LukePepin/Marco-Polo/successhider.md

hider@ISE-hider:~/Documents/Marco-Polo $ python hider_node.py
========================================
        HIDER NODE (UWB TX)             
========================================
✅ Connected to Arduino on /dev/ttyACM0

>>> Instructions: Press ENTER to trigger a wireless PING broadcast.
>>> Press Ctrl+C to exit.

>>> Sending 'SEND_PING' Command to Arduino...

[Arduino]: PING_SENT_SUCCESSFULLY

>>> Sending 'SEND_PING' Command to Arduino...

[Arduino]: PING_SENT_SUCCESSFULLY

>>> Sending 'SEND_PING' Command to Arduino...

[Arduino]: PING_SENT_SUCCESSFULLY
