LukePepin/Marco-Polo/successseeker.md

seeker@ISE-seeker:~/Documents/Marco-Polo $ python seeker_node.py
========================================
        SEEKER NODE (UWB RX)            
========================================
✅ Connected to Arduino on /dev/ttyACM1
>>> Listening the airwaves for UWB Pings from the Hider...
>>> Press Ctrl+C to exit.

🚀 >>> SUCCESS: UWB PING DETECTED WIRELESSLY FROM HIDER! <<< 🚀

🚀 >>> SUCCESS: UWB PING DETECTED WIRELESSLY FROM HIDER! <<< 🚀

🚀 >>> SUCCESS: UWB PING DETECTED WIRELESSLY FROM HIDER! <<< 🚀
