LukePepin/Marco-Polo/docs/Gantt_Matt_Inputs.docx

Gantt

W1 | W2 | W3 | W4 | W5 | W6 | W7 | W8 | W9 | W10
May 18-24 | May 25-31 | Jun 1-7 | Jun 8-14 | Jun 15-21 | Jun 22-28 | Jun 29-Jul 5 | Jul 6-12 | Jul 13-19 | Jul 20-26

Completed Work and Near-Term Transition

Task | W1 | W2 | W3 | W4 | W5 | W6 | W7 | W8 | W9 | W10 | Notes
Project charter | | | | | | | | | | | Project scope, deliverables, initial plan.
Team charter | | | | | | | | | | | Roles, expectations, communication.
Customer requirements / engineering specs | | | | | | | | | | | Portable, low-cost, offline-capable tracking system.
Initial architecture / block diagram | | | | | | | | | | | Hider, Seeker, LoRa, BLE, GPS, NUC, MQTT, Node-RED.
Hardware platform and integrations | | | | | | | | | | | T-Beams, NUC/laptop, MQTT, logging, maps.
LoRa GPS design | | | | | | | | | | | Packet design and LoRa/GPS architecture.
Build Hider/Seeker LoRa communication | | | | | | | | | | | Basic LoRa TX/RX working.
GPS-over-LoRa implementation | | | | | | | | | | | Hider GPS transmitted and Seeker parsed it.
LoRa RSSI long-range foxhunting | | | | | | | | | | | No-GPS long-range hot/cold tracking.
BLE close-range foxhunting | | | | | | | | | | | Close-range tracking and LoRa-to-BLE handoff.
Hider motion detection and case | | | | | | | | | | | Motion detection started; 3D case completed.
Node-RED/MQTT mapping integration | | | | | | | | | | | Laptop and NUC mapping pipeline established.
JSON telemetry and logging | | | | | | | | | | | Seeker outputs JSON; CSV/SQL logging explored.
NUC hotspot and wireless mapping | | | | | | | | | | | Battery NUC hotspot and wireless Seeker telemetry working.
Initial offline map investigation | | | | | | | | | | | Offline mapping research and first attempts.
Distance and bearing refinement | | | | | | | | | | | Polish GPS-to-GPS distance and bearing.
Map display improvements | | | | | | | | | | | Labels, map line, clearer Hider/Seeker visualization.
GPS / LoRa RSSI / BLE RSSI filtering | | | | | | | | | | | Moving average/median/weighted smoothing.
Navigation guidance | | | | | | | | | | | Closer/farther, bearing, direction prompts.
LoRa-to-BLE handoff tuning and tests | | | | | | | | | | | Field test long-range LoRa and close-range BLE.
Motion alerting fix | | | | | | | | | | | Alert thresholds, false alert reduction, telemetry output.
Hider battery / sleep optimization | | | | | | | | | | | Wake-on-move, periodic chirps, longer sleep life.
Offline mapping integration | | | | | | | | | | | Offline/cached local map for NUC field system.
End-to-end field testing | | | | | | | | | | | Hider-Seeker-NUC-map test with logging.
Direction-finding attempt | | | | | | | | | | | RSSI/antenna direction finding evaluation.
Directional RSSI data collection | | | | | | | | | | | Collect and analyze LoRa/BLE directional signal data.
Test data analysis vs requirements | | | | | | | | | | | Compare performance to requirements and limitations.
Final system refinement | | | | | | | | | | | Stabilize firmware, mapping, navigation, and demo flow.
Final demo / report / presentation | | | | | | | | | | | Final test results, cost, lessons learned, future work.
