LukePepin/Marco-Polo/UWB/UWB.docx

# Tab 1

In order to wire the UWB1000 to the Arduino 33 BLE Sense Lite, connect the following using dupont wires:

IRQ - D2

GND - GND

CLK - D13

MISO - D12

MOSI - D11

CSN - D10

WAKE - D4

RSTN - D3

VCC - 3.3V

GND - GND

Receiver: #include <SPI.h>

#include <DW1000.h>

const uint8_t PIN_CS = 10;

const uint8_t PIN_IRQ = 2;

const uint8_t PIN_RST = 3;

volatile boolean received = false;

volatile int interruptCount = 0;

byte data[128];

void setup() {

Serial.begin(115200);

while (!Serial) { delay(10); }

Serial.println("DWM1000 UWB Receiver - Diagnostic Mode");

// Configure interrupt pin as input

pinMode(PIN_IRQ, INPUT);

SPI.begin();

SPI.beginTransaction(SPISettings(16000000, MSBFIRST, SPI_MODE0));

DW1000.begin(PIN_IRQ, PIN_RST);

DW1000.select(PIN_CS);

Serial.println("Configuring...");

DW1000.newConfiguration();

DW1000.setDefaults();

DW1000.setDeviceAddress(2);

DW1000.setNetworkId(10);

DW1000.enableMode(DW1000.MODE_LONGDATA_RANGE_LOWPOWER);

DW1000.commitConfiguration();

// Print device info

char msg_info[128];

DW1000.getPrintableDeviceIdentifier(msg_info);

Serial.print("Device ID: "); Serial.println(msg_info);

DW1000.getPrintableExtendedUniqueIdentifier(msg_info);

Serial.print("Unique ID: "); Serial.println(msg_info);

DW1000.getPrintableNetworkIdAndShortAddress(msg_info);

Serial.print("Network ID & Address: "); Serial.println(msg_info);

// Attach interrupt BEFORE starting receive

attachInterrupt(digitalPinToInterrupt(PIN_IRQ), handleReceived, RISING);

DW1000.attachReceivedHandler(handleReceived);

// Start receiver

DW1000.newReceive();

DW1000.setDefaults();

DW1000.receivePermanently(true);

DW1000.startReceive();

Serial.println("Receiver ready - waiting for packets...");

Serial.println("Monitoring IRQ pin state:");

}

unsigned long lastCheck = 0;

unsigned long lastInterrupt = 0;

void loop() {

// Check interrupt flag

if (received) {

received = false;

lastInterrupt = millis();

Serial.println("\n>>> Packet received! <<<");

// Get data length

uint16_t len = DW1000.getDataLength();

Serial.print("Data length: "); Serial.println(len);

if (len > 0 && len < 128) {

DW1000.getData(data, len);

Serial.print("Received: ");

Serial.println((char*)data);

// Get signal quality

float rxPower = DW1000.getReceivePower();

float fpPower = DW1000.getFirstPathPower();

Serial.print("RX Power: "); Serial.print(rxPower); Serial.println(" dBm");

Serial.print("FP Power: "); Serial.print(fpPower); Serial.println(" dBm");

}

Serial.print("Total interrupts: "); Serial.println(interruptCount);

Serial.println();

}

// Periodic status check

if (millis() - lastCheck > 5000) {

lastCheck = millis();

Serial.print("[Status] IRQ count: "); Serial.print(interruptCount);

Serial.print(" | IRQ pin: "); Serial.print(digitalRead(PIN_IRQ));

Serial.print(" | Last RX: ");

if (lastInterrupt > 0) {

Serial.print((millis() - lastInterrupt) / 1000);

Serial.println(" sec ago");

} else {

Serial.println("never");

}

// Check if we're still in receive mode (fixed - no DW1000. prefix)

byte sysctrl[4];

DW1000.readBytes(SYS_CTRL, NO_SUB, sysctrl, 4);

Serial.print("SYS_CTRL: 0x");

for (int i = 3; i >= 0; i--) {

if (sysctrl[i] < 0x10) Serial.print("0");

Serial.print(sysctrl[i], HEX);

}

Serial.println();

}

}

void handleReceived() {

received = true;

interruptCount++;

}

Transmitter:

#include <SPI.h>

#include <DW1000.h>

// Pin definitions for your setup

const uint8_t PIN_CS = 10; // DW_NSS

const uint8_t PIN_IRQ = 2; // DW_IRQn

const uint8_t PIN_RST = 3; // DW_RSTn

// Message to transmit

char msg[] = "Hello UWB!";

byte data[128];

int data_len;

// Transmit interval

unsigned long lastTxTime = 0;

const unsigned long TX_INTERVAL = 1000; // 1 second

void setup() {

Serial.begin(115200);

while (!Serial) { delay(10); }

Serial.println("DWM1000 UWB Transmitter");

Serial.println("Initializing...");

// Initialize SPI

SPI.begin();

SPI.beginTransaction(SPISettings(16000000, MSBFIRST, SPI_MODE0));

// Initialize DW1000

DW1000.begin(PIN_IRQ, PIN_RST);

DW1000.select(PIN_CS);

Serial.println("DW1000 initialized");

// Configure device

DW1000.newConfiguration();

DW1000.setDefaults();

DW1000.setDeviceAddress(1);

DW1000.setNetworkId(10);

DW1000.enableMode(DW1000.MODE_LONGDATA_RANGE_LOWPOWER);

DW1000.commitConfiguration();

Serial.println("Configuration committed");

// Print device info

char msg_info[128];

DW1000.getPrintableDeviceIdentifier(msg_info);

Serial.print("Device ID: ");

Serial.println(msg_info);

DW1000.getPrintableExtendedUniqueIdentifier(msg_info);

Serial.print("Unique ID: ");

Serial.println(msg_info);

DW1000.getPrintableNetworkIdAndShortAddress(msg_info);

Serial.print("Network ID & Address: ");

Serial.println(msg_info);

Serial.println("Ready to transmit");

}

void loop() {

unsigned long currentTime = millis();

// Transmit at regular intervals

if (currentTime - lastTxTime >= TX_INTERVAL) {

transmitMessage();

lastTxTime = currentTime;

}

}

void transmitMessage() {

// Prepare data

data_len = strlen(msg) + 1;

memcpy(data, msg, data_len);

// Transmit

DW1000.newTransmit();

DW1000.setDefaults();

DW1000.setData(data, data_len);

DW1000.startTransmit();

Serial.print("Transmitted: ");

Serial.println(msg);

// Wait for transmission to complete (optional but good practice)

delay(10);

}

Tag Debug

Device ID: DECA - model: 1, version: 3, revision: 0

Address: PAN: 0A, Short Address: 02

Tag ready

Sending POLL

Sending POLL

Sending POLL

Sending POLL

Sending POLL

Sending POLL

Sending POLL

Sending POLL

Anchor Debug

Device ID: DECA - model: 1, version: 3, revision: 0

Address: PAN: 0A, Short Address: 01

Anchor ready - expecting POLL

Loop alive | received=0 sentAck=0

Loop alive | received=0 sentAck=0

Loop alive | received=0 sentAck=0

Loop alive | received=0 sentAck=0

Loop alive | received=0 sentAck=0

Loop alive | received=0 sentAck=0

Tag’s Output:

device address: 7D:00:22:EA:82:60:3B:9C

### TAG ###

Anchor’s output:

device address: 82:17:5B:D5:A9:9A:E2:9C

### ANCHOR ###

### DW1000-arduino-ranging-tag ###

DW1000 initialized ...

Committed configuration ...

Device ID: DECA - model: 1, version: 3, revision: 0

Unique ID: FF:FF:FF:FF:00:00:00:00

Network ID & Device Address: PAN: 0A, Short Address: 02

Device mode: Data rate: 110 kb/s, PRF: 16 MHz, Preamble: 2048 symbols (code #4), Channel: #5

The Arduino Stella UWB and Portenta UWB Shield use a different protocol than the DWM1000 modules. The DWM1000 uses an older, simpler method of communication and cannot communicate with the Stella over UWB.

The DWM1000 is an IEEE 802.15.4a / 802.15.4-2011 HRP UWB transceiver

Arduino Stella uses Truesense DCU040, based on NXP Trimension SR040, with an integrated FiRa MAC

### DW1000-arduino-ranging-anchor (Nano 33 BLE Sense Lite) ###

DW1000 initialized ...

Committed configuration ...

Device ID: DECA - model: 1, version: 3, revision: 0

Unique ID: FF:FF:FF:FF:00:00:00:00

Network ID & Device Address: PAN: 0A, Short Address: 01

Device mode: Data rate: 110 kb/s, PRF: 16 MHz, Preamble: 2048 symbols (code #4), Channel: #5

Anchor ready, waiting for POLL...

[DBG] irqCount=1 sentAck=0 receivedAck=0 irqLevel=0

[DBG] irqCount=3136 sentAck=0 receivedAck=0 irqLevel=0

[DBG] irqCount=6267 sentAck=0 receivedAck=0 irqLevel=0

[DBG] irqCount=9399 sentAck=0 receivedAck=0 irqLevel=0

[DBG] irqCount=12531 sentAck=0 receivedAck=0 irqLevel=0

[DBG] irqCount=15665 sentAck=0 receivedAck=0 irqLevel=0

[DBG] irqCount=18800 sentAck=0 receivedAck=0 irqLevel=0

[DBG] irqCount=21937 sentAck=0 receivedAck=0 irqLevel=0

And here is the output from the Tag, notably it prints out the last irqLevel=1 which is new.

### DW1000-arduino-ranging-tag (Nano 33 BLE Sense Lite) ###

DW1000 initialized ...

Committed configuration ...

Device ID: DECA - model: 1, version: 3, revision: 0

Unique ID: FF:FF:FF:FF:00:00:00:00

Network ID & Device Address: PAN: 0A, Short Address: 02

Device mode: Data rate: 110 kb/s, PRF: 16 MHz, Preamble: 2048 symbols (code #4), Channel: #5

Tag started, sending POLL...

[DBG] irqCount=1 sentAck=0 receivedAck=0 irqLevel=0

[DBG] irqCount=8 sentAck=0 receivedAck=0 irqLevel=1

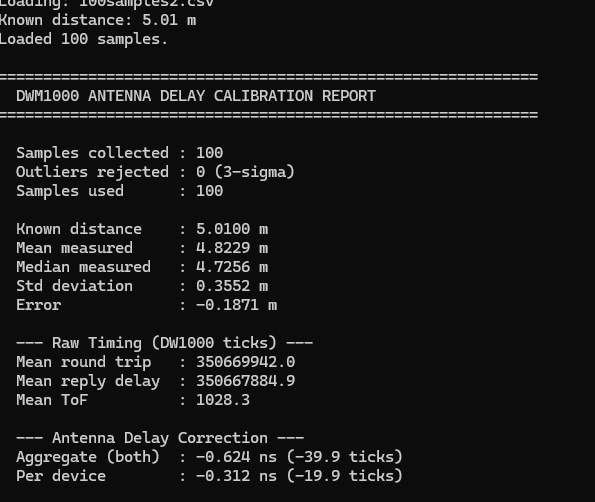
[picture p1: figure]

# Tab 2

Transmitter Code:
#include <SPI.h>

#include <DW1000.h>

const uint8_t PIN_CS = 10;

const uint8_t PIN_IRQ = 2;

const uint8_t PIN_RST = 3;

int txCount = 0;

void setup() {

Serial.begin(115200);

while (!Serial) { delay(10); }

Serial.println("=== TRANSMITTER (Auto-Sleep Disabled) ===\n");

DW1000.begin(PIN_IRQ, PIN_RST);

DW1000.select(PIN_CS);

DW1000.newConfiguration();

DW1000.setDefaults();

DW1000.setDeviceAddress(1);

DW1000.setNetworkId(10);

DW1000.enableMode(DW1000.MODE_LONGDATA_RANGE_LOWPOWER);

DW1000.commitConfiguration();

// CRITICAL: Disable auto-sleep after TX

// PMSC_CTRL1 is at register 0x36, sub-address 0x04

// ATXSLP is bit 11, ARXSLP is bit 12

// Read current value, clear those bits, write back

byte pmsc[4];

DW1000.readBytes(0x36, 0x04, pmsc, 4);

Serial.print("PMSC_CTRL1 before: 0x");

for (int i = 3; i >= 0; i--) {

if (pmsc[i] < 0x10) Serial.print("0");

Serial.print(pmsc[i], HEX);

}

Serial.println();

// Clear ATXSLP (bit 11) and ARXSLP (bit 12)

pmsc[1] &= ~0x18; // Clear bits 11 and 12 (0x08 and 0x10 in byte 1)

DW1000.writeBytes(0x36, 0x04, pmsc, 4);

// Verify

DW1000.readBytes(0x36, 0x04, pmsc, 4);

Serial.print("PMSC_CTRL1 after: 0x");

for (int i = 3; i >= 0; i--) {

if (pmsc[i] < 0x10) Serial.print("0");

Serial.print(pmsc[i], HEX);

}

Serial.println();

// Also disable interrupt mask to prevent any IRQ issues

byte zeros[4] = {0x00, 0x00, 0x00, 0x00};

DW1000.writeBytes(SYS_MASK, NO_SUB, zeros, 4);

char msg[128];

DW1000.getPrintableDeviceIdentifier(msg);

Serial.print("Device: "); Serial.println(msg);

Serial.println("\nTransmitting every 1 second...\n");

}

void loop() {

txCount++;

char msg[32];

sprintf(msg, "PING %d", txCount);

DW1000.newTransmit();

DW1000.setDefaults();

DW1000.setData((byte*)msg, strlen(msg) + 1);

DW1000.startTransmit();

// Poll for TX complete

byte status[5];

unsigned long start = millis();

while ((millis() - start) < 100) {

DW1000.readBytes(SYS_STATUS, NO_SUB, status, 5);

if (status[0] & 0x80) break; // TXFRS - frame sent

delayMicroseconds(100);

}

Serial.print("TX #"); Serial.print(txCount);

Serial.print(": "); Serial.println(msg);

// Clear status bits

byte clear[5] = {0xFF, 0xFF, 0xFF, 0xFF, 0xFF};

DW1000.writeBytes(SYS_STATUS, NO_SUB, clear, 5);

delay(1000);

}

Receiver Code:
#include <SPI.h>

#include <DW1000.h>

const uint8_t PIN_CS = 10;

const uint8_t PIN_IRQ = 2;

const uint8_t PIN_RST = 3;

byte data[128];

int rxCount = 0;

void setup() {

Serial.begin(115200);

while (!Serial) { delay(10); }

Serial.println("=== ENHANCED RECEIVER ===\n");

DW1000.begin(PIN_IRQ, PIN_RST);

DW1000.select(PIN_CS);

DW1000.newConfiguration();

DW1000.setDefaults();

DW1000.setDeviceAddress(2);

DW1000.setNetworkId(10);

DW1000.enableMode(DW1000.MODE_LONGDATA_RANGE_LOWPOWER);

DW1000.commitConfiguration();

char msg[128];

DW1000.getPrintableDeviceIdentifier(msg);

Serial.print("Device: "); Serial.println(msg);

startReceiver();

Serial.println("Listening...\n");

}

void loop() {

byte status[5];

DW1000.readBytes(SYS_STATUS, NO_SUB, status, 5);

boolean dataReady = (status[1] & 0x20);

boolean goodCRC = (status[1] & 0x40);

if (dataReady) {

rxCount++;

if (goodCRC) {

uint16_t len = DW1000.getDataLength();

if (len > 0 && len < 128) {

DW1000.getData(data, len);

data[len] = 0;

// Get RX timestamp (40-bit, ~15.65 ps resolution)

DW1000Time rxTime;

DW1000.getReceiveTimestamp(rxTime);

// Get signal quality metrics

float rxPower = DW1000.getReceivePower(); // Total RX power (dBm)

float fpPower = DW1000.getFirstPathPower(); // First path power (dBm)

float quality = DW1000.getReceiveQuality(); // Signal quality indicator

// Read frame info register for more details

byte finfo[4];

DW1000.readBytes(RX_FINFO, NO_SUB, finfo, 4);

uint16_t frameLen = (finfo[0] | ((finfo[1] & 0x03) << 8));

uint8_t rxPACC = ((finfo[2] >> 4) | ((finfo[3] & 0x0F) << 4)); // Preamble symbols accumulated

uint8_t rxPSR = (finfo[1] >> 6) & 0x03; // Preamble length

uint8_t rxDataRate = (finfo[1] >> 4) & 0x03; // Data rate

// Print everything

Serial.println("=====================================");

Serial.print("RX #"); Serial.println(rxCount);

Serial.print(" Data: "); Serial.println((char*)data);

Serial.print(" Length: "); Serial.print(frameLen); Serial.println(" bytes");

Serial.println();

Serial.println(" --- Signal Quality ---");

Serial.print(" RX Power: "); Serial.print(rxPower, 2); Serial.println(" dBm");

Serial.print(" FP Power: "); Serial.print(fpPower, 2); Serial.println(" dBm");

Serial.print(" FP/RX Ratio: "); Serial.print(fpPower - rxPower, 2); Serial.println(" dB");

Serial.print(" Quality: "); Serial.println(quality, 2);

Serial.println();

Serial.println(" --- Timing ---");

Serial.print(" RX Timestamp: ");

Serial.print((uint32_t)(rxTime.getTimestamp() >> 8)); // Print upper bits

Serial.println();

Serial.print(" Time (us): "); Serial.println(rxTime.getAsMicroSeconds(), 2);

Serial.println();

Serial.println(" --- Frame Info ---");

Serial.print(" Preamble acc: "); Serial.println(rxPACC);

Serial.print(" Data rate: ");

switch(rxDataRate) {

case 0: Serial.println("110 kbps"); break;

case 1: Serial.println("850 kbps"); break;

case 2: Serial.println("6.8 Mbps"); break;

default: Serial.println("unknown"); break;

}

Serial.println();

}

} else {

Serial.print("RX #"); Serial.print(rxCount);

Serial.println(": BAD CRC");

}

byte clear[5] = {0xFF, 0xFF, 0xFF, 0xFF, 0xFF};

DW1000.writeBytes(SYS_STATUS, NO_SUB, clear, 5);

startReceiver();

}

delay(1);

}

void startReceiver() {

DW1000.newReceive();

DW1000.setDefaults();

DW1000.receivePermanently(true);

DW1000.startReceive();

}

# Tab 3

Metric | Description | Use
RX Power | Total received signal power | General Signal Strength
FP Power | First path (direct) signal power | Line-of-sight strength
FP/RX Ratio | Difference between above | NLOS detection (<-6dB suggests multipath/NLOS)
Quality | Preamble accumulation quality | Confidence in reception
RX Timestamp | 40-bit timestamp (~15.65 ps resolution) | This is what we need for ranging
Preamble acc | Number of preamble symbols accumulated | Signal acquisition quality
Data rate | Detected data rate | Confirms configuration

Link to the Qorvo website for DW1000: HERE (https://www.qorvo.com/products/p/DW1000#documents).

# TWR

Tag:
#include <SPI.h>

#include <DW1000.h>

const uint8_t PIN_CS = 10;

const uint8_t PIN_IRQ = 2;

const uint8_t PIN_RST = 3;

#define MSG_POLL 0x01

#define MSG_RESPONSE 0x02

// Speed of light in m/s

#define SPEED_OF_LIGHT 299702547.0

// DW1000 time unit is ~15.65 picoseconds (1 / (499.2MHz * 128))

#define DW_TIME_UNITS 15.65e-12

byte rxBuffer[20];

byte txBuffer[20];

int rangeCount = 0;

static inline void clearStatusAll() {

byte clear[5] = {0xFF, 0xFF, 0xFF, 0xFF, 0xFF};

DW1000.writeBytes(SYS_STATUS, NO_SUB, clear, 5);

}

static inline bool waitForRxGood(uint16_t timeoutMs) {

byte status[5];

unsigned long start = millis();

while ((millis() - start) < timeoutMs) {

DW1000.readBytes(SYS_STATUS, NO_SUB, status, 5);

// RXFCG (Receive Frame Good) bit in SYS_STATUS (DW1000 datasheet)

if (status[1] & 0x40) return true;

delayMicroseconds(100);

}

return false;

}

static inline bool waitForTxDone(uint16_t timeoutMs) {

byte status[5];

unsigned long start = millis();

while ((millis() - start) < timeoutMs) {

DW1000.readBytes(SYS_STATUS, NO_SUB, status, 5);

// TXFRS (Transmit Frame Sent)

if (status[0] & 0x80) return true;

delayMicroseconds(50);

}

return false;

}

void setup() {

Serial.begin(115200);

while (!Serial) { delay(10); }

Serial.println("=== SS-TWR TAG (updated) ===\n");

DW1000.begin(PIN_IRQ, PIN_RST);

DW1000.select(PIN_CS);

DW1000.newConfiguration();

DW1000.setDefaults();

DW1000.setDeviceAddress(2);

DW1000.setNetworkId(10);

DW1000.enableMode(DW1000.MODE_LONGDATA_RANGE_LOWPOWER);

DW1000.commitConfiguration();

// Disable auto-sleep

byte pmsc[4];

DW1000.readBytes(0x36, 0x04, pmsc, 4);

pmsc[1] &= ~0x18;

DW1000.writeBytes(0x36, 0x04, pmsc, 4);

// Disable interrupts

byte zeros[4] = {0x00, 0x00, 0x00, 0x00};

DW1000.writeBytes(SYS_MASK, NO_SUB, zeros, 4);

Serial.println("Starting ranging in 2 seconds...\n");

delay(2000);

}

void loop() {

rangeCount++;

// ========== SEND POLL ==========

txBuffer[0] = MSG_POLL;

DW1000.newTransmit();

DW1000.setDefaults();

DW1000.setData(txBuffer, 1);

DW1000.startTransmit();

if (!waitForTxDone(50)) {

Serial.print("Range #"); Serial.print(rangeCount);

Serial.println(": TX TIMEOUT (POLL)");

clearStatusAll();

delay(250);

return;

}

// Get T1 (POLL TX timestamp)

DW1000Time t1;

DW1000.getTransmitTimestamp(t1);

clearStatusAll();

// ========== WAIT FOR RESPONSE #1 (the one whose RX timestamp is T4) ==========

DW1000.newReceive();

DW1000.setDefaults();

DW1000.receivePermanently(false);

DW1000.startReceive();

if (!waitForRxGood(100)) {

Serial.print("Range #"); Serial.print(rangeCount);

Serial.println(": TIMEOUT (no first response)");

clearStatusAll();

delay(1000);

return;

}

// Capture T4 from FIRST response frame

DW1000Time t4_first;

DW1000.getReceiveTimestamp(t4_first);

// Read & discard first response payload (we don't need it, but clear RX buffer cleanly)

uint16_t len1 = DW1000.getDataLength();

if (len1 > sizeof(rxBuffer)) len1 = sizeof(rxBuffer);

DW1000.getData(rxBuffer, len1);

clearStatusAll();

// ========== WAIT FOR RESPONSE #2 (contains replyDelay = T3 - T2) ==========

DW1000.newReceive();

DW1000.setDefaults();

DW1000.receivePermanently(false);

DW1000.startReceive();

if (!waitForRxGood(100)) {

Serial.print("Range #"); Serial.print(rangeCount);

Serial.println(": TIMEOUT (no second response)");

clearStatusAll();

delay(1000);

return;

}

uint16_t len2 = DW1000.getDataLength();

if (len2 > sizeof(rxBuffer)) len2 = sizeof(rxBuffer);

DW1000.getData(rxBuffer, len2);

clearStatusAll();

if (rxBuffer[0] != MSG_RESPONSE || len2 < 6) {

Serial.print("Range #"); Serial.print(rangeCount);

Serial.println(": Invalid response #2");

delay(1000);

return;

}

// Extract reply delay (T3 - T2) from message (40-bit, little-endian)

int64_t replyDelay = 0;

replyDelay |= ((int64_t)rxBuffer[1] << 0);

replyDelay |= ((int64_t)rxBuffer[2] << 8);

replyDelay |= ((int64_t)rxBuffer[3] << 16);

replyDelay |= ((int64_t)rxBuffer[4] << 24);

replyDelay |= ((int64_t)rxBuffer[5] << 32);

// ========== CALCULATE DISTANCE ==========

// Round trip must be to FIRST response: (T4_first - T1)

int64_t roundTrip = t4_first.getTimestamp() - t1.getTimestamp();

// Handle 40-bit wraparound

if (roundTrip < 0) {

roundTrip += 0x10000000000LL; // Add 2^40

}

// Time of flight = (roundTrip - replyDelay) / 2

int64_t tof = (roundTrip - replyDelay) / 2;

// Convert to seconds then distance

double tofSeconds = (double)tof * DW_TIME_UNITS;

double distance = tofSeconds * SPEED_OF_LIGHT;

// Print results (avoid truncating 40-bit values)

Serial.println("-----------------------------");

Serial.print("Range #"); Serial.println(rangeCount);

Serial.print(" Round trip (T4-T1): "); Serial.print((long long)roundTrip); Serial.println(" ticks");

Serial.print(" Reply delay (T3-T2): "); Serial.print((long long)replyDelay); Serial.println(" ticks");

Serial.print(" TOF: "); Serial.print((long long)tof); Serial.println(" ticks");

Serial.print(" >>> Distance: "); Serial.print(distance, 2); Serial.println(" m <<<");

Serial.println();

delay(1000);

}

Anchor:

#include <SPI.h>

#include <DW1000.h>

const uint8_t PIN_CS = 10;

const uint8_t PIN_IRQ = 2;

const uint8_t PIN_RST = 3;

#define MSG_POLL 0x01

#define MSG_RESPONSE 0x02

byte rxBuffer[20];

byte txBuffer[20];

int rangeCount = 0;

void setup() {

Serial.begin(115200);

while (!Serial) { delay(10); }

Serial.println("=== SS-TWR ANCHOR ===\n");

DW1000.begin(PIN_IRQ, PIN_RST);

DW1000.select(PIN_CS);

DW1000.newConfiguration();

DW1000.setDefaults();

DW1000.setDeviceAddress(1);

DW1000.setNetworkId(10);

DW1000.enableMode(DW1000.MODE_LONGDATA_RANGE_LOWPOWER);

DW1000.commitConfiguration();

// Disable auto-sleep

byte pmsc[4];

DW1000.readBytes(0x36, 0x04, pmsc, 4);

pmsc[1] &= ~0x18;

DW1000.writeBytes(0x36, 0x04, pmsc, 4);

// Disable interrupts

byte zeros[4] = {0x00, 0x00, 0x00, 0x00};

DW1000.writeBytes(SYS_MASK, NO_SUB, zeros, 4);

Serial.println("Listening for POLL...\n");

startReceiver();

}

void loop() {

byte status[5];

DW1000.readBytes(SYS_STATUS, NO_SUB, status, 5);

boolean dataReady = (status[1] & 0x20);

boolean goodCRC = (status[1] & 0x40);

if (dataReady && goodCRC) {

// Get RX timestamp (T2) immediately

DW1000Time t2;

DW1000.getReceiveTimestamp(t2);

uint16_t len = DW1000.getDataLength();

DW1000.getData(rxBuffer, len);

// Clear status

byte clear[5] = {0xFF, 0xFF, 0xFF, 0xFF, 0xFF};

DW1000.writeBytes(SYS_STATUS, NO_SUB, clear, 5);

if (rxBuffer[0] == MSG_POLL) {

rangeCount++;

// Prepare RESPONSE

txBuffer[0] = MSG_RESPONSE;

// Send RESPONSE

DW1000.newTransmit();

DW1000.setDefaults();

DW1000.setData(txBuffer, 1);

DW1000.startTransmit();

// Poll for TX complete

unsigned long start = millis();

while ((millis() - start) < 50) {

DW1000.readBytes(SYS_STATUS, NO_SUB, status, 5);

if (status[0] & 0x80) break;

delayMicroseconds(50);

}

// Get TX timestamp (T3)

DW1000Time t3;

DW1000.getTransmitTimestamp(t3);

// Calculate reply delay (T3 - T2) in DW1000 time units

int64_t replyDelay = t3.getTimestamp() - t2.getTimestamp();

// Clear status

DW1000.writeBytes(SYS_STATUS, NO_SUB, clear, 5);

// Now send a second message with the reply delay embedded

txBuffer[0] = MSG_RESPONSE;

// Store reply delay as 5 bytes (40-bit timestamp)

txBuffer[1] = (replyDelay >> 0) & 0xFF;

txBuffer[2] = (replyDelay >> 8) & 0xFF;

txBuffer[3] = (replyDelay >> 16) & 0xFF;

txBuffer[4] = (replyDelay >> 24) & 0xFF;

txBuffer[5] = (replyDelay >> 32) & 0xFF;

DW1000.newTransmit();

DW1000.setDefaults();

DW1000.setData(txBuffer, 6);

DW1000.startTransmit();

// Wait for TX

start = millis();

while ((millis() - start) < 50) {

DW1000.readBytes(SYS_STATUS, NO_SUB, status, 5);

if (status[0] & 0x80) break;

delayMicroseconds(50);

}

DW1000.writeBytes(SYS_STATUS, NO_SUB, clear, 5);

Serial.print("Range #"); Serial.print(rangeCount);

Serial.print(" | Reply delay: "); Serial.print((uint32_t)replyDelay);

Serial.println(" ticks");

}

startReceiver();

} else if (dataReady) {

byte clear[5] = {0xFF, 0xFF, 0xFF, 0xFF, 0xFF};

DW1000.writeBytes(SYS_STATUS, NO_SUB, clear, 5);

startReceiver();

}

delay(1);

}

void startReceiver() {

DW1000.newReceive();

DW1000.setDefaults();

DW1000.receivePermanently(true);

DW1000.startReceive();

}

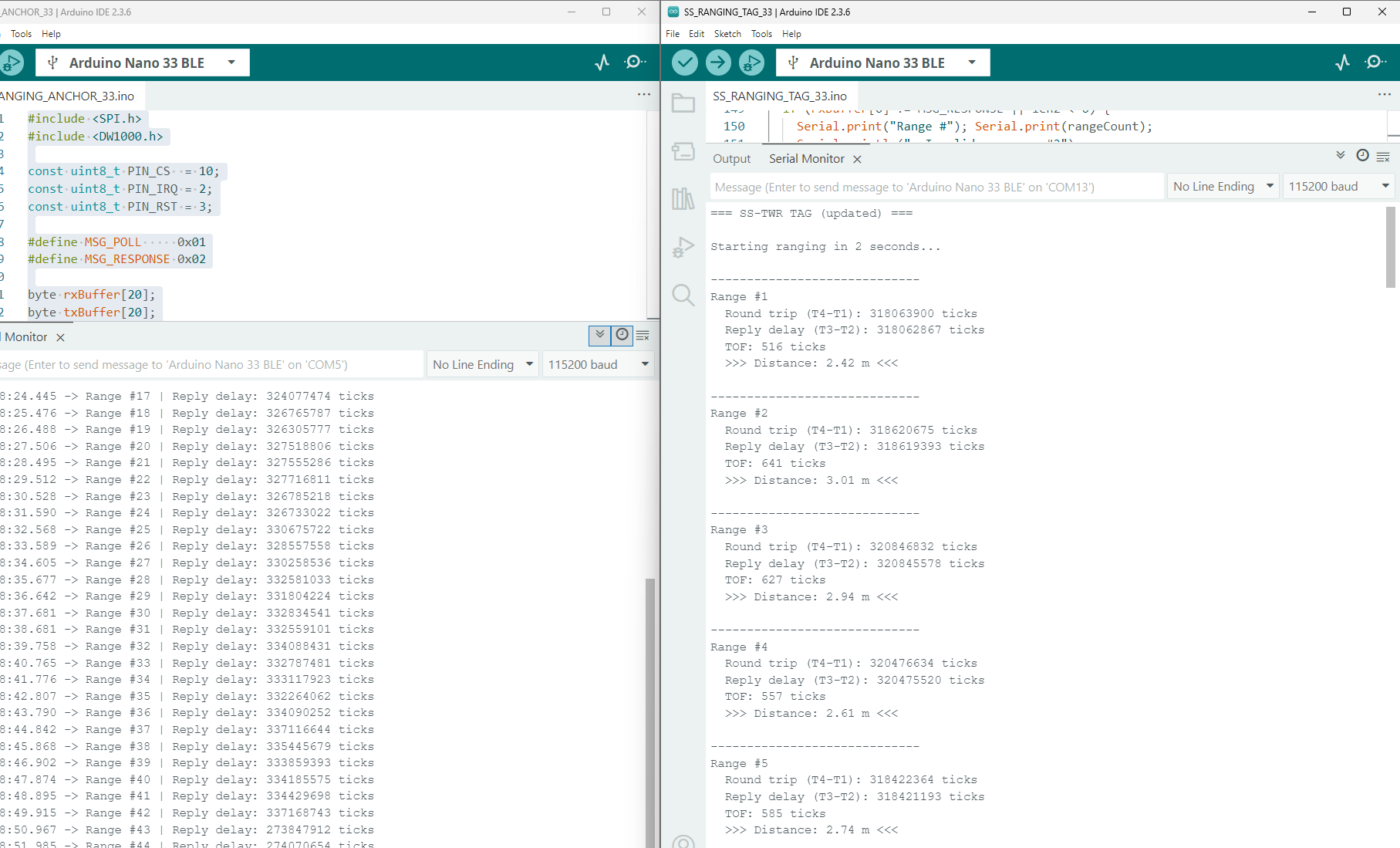
[picture p2: figure]

# Responder

// ============================================================

// DWM1000 Antenna Delay Calibration — RESPONDER

// Board: Arduino Nano 33 BLE Sense Lite + DWM1000 shield

//

// Purpose: Respond to initiator's POLL messages during

// antenna delay calibration. Logs its own RX

// diagnostics and environmental data over serial.

//

// *** BLE is NOT initialized — zero radio interference ***

// *** All output is CSV over USB Serial at 115200 baud ***

//

// Serial Commands:

// delay XXXXX — set antenna delay register (0–65535)

// status — print current settings

// env — read environmental sensors once

// reset — reset exchange counter

// ============================================================

#include <SPI.h>

#include <DW1000.h>

#include <Arduino_LPS22HB.h>

// ---------- DW1000 wiring ----------

const uint8_t PIN_CS = 10;

const uint8_t PIN_IRQ = 2;

const uint8_t PIN_RST = 3;

// ---------- TWR message types ----------

#define MSG_POLL 0x01

#define MSG_RESPONSE 0x02

// ---------- antenna delay ----------

uint16_t antennaDelay = 0; // ZERO for calibration

#define DW_TIME_UNITS 15.65e-12

// ---------- state ----------

uint16_t exchangeCount = 0;

bool sensorsAvail = false;

float envTemp = 0.0;

float envPressure = 0.0;

// ---------- buffers ----------

byte rxBuffer[20];

byte txBuffer[20];

// ============================================================

// Low-level helpers

// ============================================================

static inline void clearStatusAll() {

byte clear[5] = {0xFF, 0xFF, 0xFF, 0xFF, 0xFF};

DW1000.writeBytes(SYS_STATUS, NO_SUB, clear, 5);

}

static inline void softResetRx() {

byte pmsc[4];

DW1000.readBytes(0x36, 0x00, pmsc, 4);

pmsc[3] &= 0xCF;

DW1000.writeBytes(0x36, 0x00, pmsc, 4);

pmsc[3] |= 0x30;

DW1000.writeBytes(0x36, 0x00, pmsc, 4);

}

void startReceiver() {

softResetRx();

DW1000.newReceive();

DW1000.receivePermanently(true);

DW1000.startReceive();

}

void setAntennaDelay(uint16_t delay16) {

byte d[2];

d[0] = delay16 & 0xFF;

d[1] = (delay16 >> 8) & 0xFF;

DW1000.writeBytes(0x18, 0x00, d, 2); // TX_ANTD

DW1000.writeBytes(0x2E, 0x1804, d, 2); // LDE_RXANTD

}

uint16_t readAntennaDelay() {

byte d[2];

DW1000.readBytes(0x18, 0x00, d, 2);

return d[0] | (d[1] << 8);

}

void readEnvironment() {

if (!sensorsAvail) return;

envTemp = BARO.readTemperature();

envPressure = BARO.readPressure() * 10.0f; // kPa → hPa

}

void printStatus() {

Serial.println(F("\n--- Responder Status ---"));

Serial.print(F(" Antenna delay reg : ")); Serial.println(antennaDelay);

Serial.print(F(" Antenna delay (ns): ")); Serial.println((double)antennaDelay * DW_TIME_UNITS * 1e9, 3);

Serial.print(F(" Exchanges served : ")); Serial.println(exchangeCount);

Serial.print(F(" Sensors available : ")); Serial.println(sensorsAvail ? "YES" : "NO");

if (sensorsAvail) {

readEnvironment();

Serial.print(F(" Temperature (C) : ")); Serial.println(envTemp, 2);

Serial.print(F(" Pressure (hPa) : ")); Serial.println(envPressure, 1);

}

Serial.println(F("------------------------\n"));

}

void handleSerial() {

if (!Serial.available()) return;

String cmd = Serial.readStringUntil('\n');

cmd.trim();

cmd.toLowerCase();

if (cmd.startsWith("delay ")) {

long d = cmd.substring(6).toInt();

if (d >= 0 && d <= 65535) {

antennaDelay = (uint16_t)d;

setAntennaDelay(antennaDelay);

Serial.print(F("Antenna delay set to: ")); Serial.print(antennaDelay);

Serial.print(F(" (")); Serial.print((double)antennaDelay * DW_TIME_UNITS * 1e9, 3);

Serial.println(F(" ns)"));

startReceiver();

}

} else if (cmd == "status") {

printStatus();

} else if (cmd == "env") {

readEnvironment();

Serial.print(F("Temp: ")); Serial.print(envTemp, 2); Serial.print(F(" C "));

Serial.print(F("Pressure: ")); Serial.print(envPressure, 1); Serial.println(F(" hPa"));

} else if (cmd == "reset") {

exchangeCount = 0;

Serial.println(F("Exchange counter reset."));

} else {

Serial.println(F("Commands: delay XXXXX, status, env, reset"));

}

}

// ============================================================

void setup() {

Serial.begin(115200);

while (!Serial && millis() < 5000);

Serial.println(F("============================================"));

Serial.println(F(" DWM1000 Calibration — RESPONDER"));

Serial.println(F(" NO BLE — Serial output only"));

Serial.println(F("============================================"));

// ----- Environmental sensor (LPS22HB: temp + pressure) -----

sensorsAvail = true;

if (!BARO.begin()) {

Serial.println(F("WARN: LPS22HB (temp/pressure) not found"));

sensorsAvail = false;

}

if (sensorsAvail) {

Serial.println(F("LPS22HB sensor: OK"));

}

// ----- DW1000 init -----

DW1000.begin(PIN_IRQ, PIN_RST);

DW1000.select(PIN_CS);

DW1000.newConfiguration();

DW1000.setDefaults();

DW1000.setDeviceAddress(1); // responder address

DW1000.setNetworkId(10);

DW1000.enableMode(DW1000.MODE_LONGDATA_RANGE_LOWPOWER);

DW1000.commitConfiguration();

// Set antenna delay

setAntennaDelay(antennaDelay);

// Disable auto-sleep

byte pmsc[4];

DW1000.readBytes(0x36, 0x04, pmsc, 4);

pmsc[1] &= ~0x18;

DW1000.writeBytes(0x36, 0x04, pmsc, 4);

// Disable DW1000 interrupts

byte zeros[4] = {0, 0, 0, 0};

DW1000.writeBytes(SYS_MASK, NO_SUB, zeros, 4);

uint16_t readBack = readAntennaDelay();

Serial.print(F("Antenna delay register: ")); Serial.print(readBack);

Serial.print(F(" (")); Serial.print((double)readBack * DW_TIME_UNITS * 1e9, 3);

Serial.println(F(" ns)"));

Serial.println();

printStatus();

Serial.println(F("# Responder log — one line per exchange"));

Serial.println(F("exchange,millis,rx_power_dBm,fp_power_dBm,quality,reply_delay_ticks,temp_C,pressure_hPa"));

startReceiver();

Serial.println(F("\nListening for POLL messages...\n"));

}

// ============================================================

void loop() {

handleSerial();

// Check DW1000 RX status

byte status[5];

DW1000.readBytes(SYS_STATUS, NO_SUB, status, 5);

bool dataReady = (status[1] & 0x20);

bool goodCRC = (status[1] & 0x40);

if (dataReady && goodCRC) {

// T2 — RX timestamp of the poll

DW1000Time t2;

DW1000.getReceiveTimestamp(t2);

// Signal diagnostics of the received poll

float rxPower = DW1000.getReceivePower();

float fpPower = DW1000.getFirstPathPower();

float quality = DW1000.getReceiveQuality();

// Read payload

uint16_t len = DW1000.getDataLength();

if (len > sizeof(rxBuffer)) len = sizeof(rxBuffer);

DW1000.getData(rxBuffer, len);

clearStatusAll();

if (rxBuffer[0] == MSG_POLL) {

exchangeCount++;

// ---- Send RESPONSE #1 (immediate) ----

txBuffer[0] = MSG_RESPONSE;

txBuffer[1] = 0x01; // responder ID

DW1000.newTransmit();

DW1000.setData(txBuffer, 2);

DW1000.startTransmit();

// Wait for TX done

unsigned long start = millis();

while ((millis() - start) < 50) {

DW1000.readBytes(SYS_STATUS, NO_SUB, status, 5);

if (status[0] & 0x80) break;

delayMicroseconds(50);

}

// T3 — TX timestamp of response

DW1000Time t3;

DW1000.getTransmitTimestamp(t3);

int64_t replyDelay = t3.getTimestamp() - t2.getTimestamp();

clearStatusAll();

// ---- Send RESPONSE #2 (carries reply delay) ----

txBuffer[0] = MSG_RESPONSE;

txBuffer[1] = (replyDelay >> 0) & 0xFF;

txBuffer[2] = (replyDelay >> 8) & 0xFF;

txBuffer[3] = (replyDelay >> 16) & 0xFF;

txBuffer[4] = (replyDelay >> 24) & 0xFF;

txBuffer[5] = (replyDelay >> 32) & 0xFF;

DW1000.newTransmit();

DW1000.setData(txBuffer, 6);

DW1000.startTransmit();

start = millis();

while ((millis() - start) < 50) {

DW1000.readBytes(SYS_STATUS, NO_SUB, status, 5);

if (status[0] & 0x80) break;

delayMicroseconds(50);

}

clearStatusAll();

// Read environment every 25th exchange

if (sensorsAvail && (exchangeCount % 25 == 0 || exchangeCount == 1)) {

readEnvironment();

}

// CSV log for responder

Serial.print(exchangeCount); Serial.print(',');

Serial.print(millis()); Serial.print(',');

Serial.print(rxPower, 2); Serial.print(',');

Serial.print(fpPower, 2); Serial.print(',');

Serial.print(quality, 2); Serial.print(',');

Serial.print((long)replyDelay); Serial.print(',');

Serial.print(envTemp, 2); Serial.print(',');

Serial.println(envPressure, 1);

}

startReceiver();

} else if (dataReady) {

// Bad CRC

clearStatusAll();

startReceiver();

}

delayMicroseconds(100);

}

# Initiator

// ============================================================

// DWM1000 Antenna Delay Calibration — INITIATOR

// Board: Arduino Nano 33 BLE Sense Lite + DWM1000 shield

//

// Purpose: Collect raw TWR data at a known distance for

// per-module antenna delay calibration.

//

// *** BLE is NOT initialized — zero radio interference ***

// *** All output is CSV over USB Serial at 115200 baud ***

//

// Procedure:

// 1. Flash this sketch on Device A (the initiator)

// 2. Flash cal_responder.ino on Device B

// 3. Place 1.0 m apart, antennas facing each other

// 4. Open Serial Monitor on Device A at 115200

// 5. Type 'start' to begin collecting samples

// 6. Copy CSV output → paste into spreadsheet or use

// cal_postprocess.py to compute antenna delay

//

// Serial Commands:

// start — begin collecting (default 500 samples)

// start N — collect N samples (e.g. 'start 1000')

// stop — abort collection

// delay XXXXX — set antenna delay register (0–65535)

// distance X.XX — set known reference distance in meters

// status — print current settings

// env — read environmental sensors once

// ============================================================

#include <SPI.h>

#include <DW1000.h>

#include <Arduino_LPS22HB.h> // Temperature + Barometric Pressure

// ---------- DW1000 wiring ----------

const uint8_t PIN_CS = 10;

const uint8_t PIN_IRQ = 2; // not used (polled)

const uint8_t PIN_RST = 3;

// ---------- TWR message types ----------

#define MSG_POLL 0x01

#define MSG_RESPONSE 0x02

// ---------- physics ----------

#define SPEED_OF_LIGHT 299702547.0 // m/s in air (sea level)

#define DW_TIME_UNITS 15.65e-12 // ~15.65 ps per tick

// ---------- timing ----------

#define RANGE_INTERVAL_MS 50 // fast: 20 Hz during cal

#define RX_TIMEOUT_MS 80

#define TX_TIMEOUT_MS 50

// ---------- antenna delay ----------

// DW1000 16-bit register, each LSB = 15.65 ps

// Default ~16384 from setDefaults(), typical calibrated ~32900

uint16_t antennaDelay = 0; // START AT ZERO for calibration

// ---------- calibration state ----------

float knownDistance = 1.00; // meters — set to your measured distance

uint16_t targetSamples = 500;

uint16_t sampleCount = 0;

bool collecting = false;

bool sensorsAvail = false;

// ---------- environmental sensor cache ----------

float envTemp = 0.0;

float envPressure = 0.0;

// ---------- buffers ----------

byte rxBuffer[20];

byte txBuffer[20];

// ============================================================

// Low-level DW1000 helpers (polled, no interrupts)

// ============================================================

static inline void clearStatusAll() {

byte clear[5] = {0xFF, 0xFF, 0xFF, 0xFF, 0xFF};

DW1000.writeBytes(SYS_STATUS, NO_SUB, clear, 5);

}

static inline bool waitForTxDone(uint16_t timeoutMs) {

byte status[5];

unsigned long start = millis();

while ((millis() - start) < timeoutMs) {

DW1000.readBytes(SYS_STATUS, NO_SUB, status, 5);

if (status[0] & 0x80) return true; // TXFRS

delayMicroseconds(50);

}

return false;

}

static inline bool waitForRxGood(uint16_t timeoutMs) {

byte status[5];

unsigned long start = millis();

while ((millis() - start) < timeoutMs) {

DW1000.readBytes(SYS_STATUS, NO_SUB, status, 5);

if (status[1] & 0x40) return true; // RXFCG

delayMicroseconds(100);

}

return false;

}

// ---------- Set DW1000 antenna delay register ----------

void setAntennaDelay(uint16_t delay16) {

// TX_ANTD register: 0x18, 2 bytes

byte d[2];

d[0] = delay16 & 0xFF;

d[1] = (delay16 >> 8) & 0xFF;

DW1000.writeBytes(0x18, 0x00, d, 2); // TX_ANTD

// LDE_RXANTD: register 0x2E, sub 0x1804, 2 bytes

DW1000.writeBytes(0x2E, 0x1804, d, 2); // RX antenna delay

}

uint16_t readAntennaDelay() {

byte d[2];

DW1000.readBytes(0x18, 0x00, d, 2);

return d[0] | (d[1] << 8);

}

// ---------- Read environmental sensors ----------

void readEnvironment() {

if (!sensorsAvail) return;

envTemp = BARO.readTemperature();

envPressure = BARO.readPressure() * 10.0f; // kPa → hPa

}

// ---------- Print current config ----------

void printStatus() {

Serial.println(F("\n--- Calibration Status ---"));

Serial.print(F(" Antenna delay reg : ")); Serial.println(antennaDelay);

Serial.print(F(" Antenna delay (ns): ")); Serial.println((double)antennaDelay * DW_TIME_UNITS * 1e9, 3);

Serial.print(F(" Known distance (m): ")); Serial.println(knownDistance, 3);

Serial.print(F(" Target samples : ")); Serial.println(targetSamples);

Serial.print(F(" Collecting : ")); Serial.println(collecting ? "YES" : "NO");

Serial.print(F(" Sensors available : ")); Serial.println(sensorsAvail ? "YES" : "NO");

if (sensorsAvail) {

readEnvironment();

Serial.print(F(" Temperature (C) : ")); Serial.println(envTemp, 2);

Serial.print(F(" Pressure (hPa) : ")); Serial.println(envPressure, 1);

}

Serial.println(F("--------------------------\n"));

}

// ---------- Parse serial commands ----------

void handleSerial() {

if (!Serial.available()) return;

String cmd = Serial.readStringUntil('\n');

cmd.trim();

cmd.toLowerCase();

if (cmd == "start" || cmd.startsWith("start ")) {

if (cmd.length() > 6) {

int n = cmd.substring(6).toInt();

if (n > 0 && n <= 10000) targetSamples = n;

}

sampleCount = 0;

collecting = true;

// Read environment at start

readEnvironment();

// Print CSV header

Serial.println(F("\n# DWM1000 Antenna Delay Calibration — Initiator"));

Serial.print(F("# Known distance: ")); Serial.print(knownDistance, 4); Serial.println(F(" m"));

Serial.print(F("# Antenna delay register: ")); Serial.println(antennaDelay);

Serial.print(F("# Antenna delay (ns): ")); Serial.println((double)antennaDelay * DW_TIME_UNITS * 1e9, 3);

Serial.print(F("# Target samples: ")); Serial.println(targetSamples);

Serial.print(F("# Start temp (C): ")); Serial.println(envTemp, 2);

Serial.print(F("# Start pressure (hPa): ")); Serial.println(envPressure, 1);

Serial.print(F("# Range interval: ")); Serial.print(RANGE_INTERVAL_MS); Serial.println(F(" ms"));

Serial.println(F("#"));

Serial.println(F("sample,millis,distance_m,round_trip_ticks,reply_delay_ticks,tof_ticks,rx_power_dBm,fp_power_dBm,quality,temp_C,pressure_hPa"));

} else if (cmd == "stop") {

collecting = false;

Serial.println(F("\n# Collection stopped by user."));

} else if (cmd.startsWith("delay ")) {

long d = cmd.substring(6).toInt();

if (d >= 0 && d <= 65535) {

antennaDelay = (uint16_t)d;

setAntennaDelay(antennaDelay);

Serial.print(F("Antenna delay set to: ")); Serial.print(antennaDelay);

Serial.print(F(" (")); Serial.print((double)antennaDelay * DW_TIME_UNITS * 1e9, 3);

Serial.println(F(" ns)"));

} else {

Serial.println(F("ERROR: delay must be 0–65535"));

}

} else if (cmd.startsWith("distance ")) {

float d = cmd.substring(9).toFloat();

if (d > 0.0 && d < 1000.0) {

knownDistance = d;

Serial.print(F("Known distance set to: ")); Serial.print(knownDistance, 4); Serial.println(F(" m"));

} else {

Serial.println(F("ERROR: distance must be > 0 and < 1000 m"));

}

} else if (cmd == "status") {

printStatus();

} else if (cmd == "env") {

readEnvironment();

Serial.print(F("Temp: ")); Serial.print(envTemp, 2); Serial.print(F(" C "));

Serial.print(F("Pressure: ")); Serial.print(envPressure, 1); Serial.println(F(" hPa"));

} else {

Serial.println(F("Commands: start [N], stop, delay XXXXX, distance X.XX, status, env"));

}

}

// ============================================================

void setup() {

Serial.begin(115200);

while (!Serial && millis() < 5000); // wait up to 5s for USB serial

Serial.println(F("============================================"));

Serial.println(F(" DWM1000 Calibration — INITIATOR"));

Serial.println(F(" NO BLE — Serial CSV output only"));

Serial.println(F("============================================"));

// ----- Environmental sensor (LPS22HB: temp + pressure) -----

sensorsAvail = true;

if (!BARO.begin()) {

Serial.println(F("WARN: LPS22HB (temp/pressure) not found"));

sensorsAvail = false;

}

if (sensorsAvail) {

Serial.println(F("LPS22HB sensor: OK"));

}

// ----- DW1000 init -----

DW1000.begin(PIN_IRQ, PIN_RST);

DW1000.select(PIN_CS);

DW1000.newConfiguration();

DW1000.setDefaults();

DW1000.setDeviceAddress(101); // initiator address

DW1000.setNetworkId(10);

DW1000.enableMode(DW1000.MODE_LONGDATA_RANGE_LOWPOWER);

DW1000.commitConfiguration();

// Set antenna delay to ZERO for raw measurement

setAntennaDelay(antennaDelay);

// Disable auto-sleep

byte pmsc[4];

DW1000.readBytes(0x36, 0x04, pmsc, 4);

pmsc[1] &= ~0x18;

DW1000.writeBytes(0x36, 0x04, pmsc, 4);

// Disable DW1000 interrupts (polled)

byte zeros[4] = {0, 0, 0, 0};

DW1000.writeBytes(SYS_MASK, NO_SUB, zeros, 4);

// Verify antenna delay register

uint16_t readBack = readAntennaDelay();

Serial.print(F("Antenna delay register: ")); Serial.print(readBack);

Serial.print(F(" (")); Serial.print((double)readBack * DW_TIME_UNITS * 1e9, 3);

Serial.println(F(" ns)"));

Serial.println();

printStatus();

Serial.println(F("Type 'start' to begin collecting, 'status' for info."));

Serial.println(F("Set distance first with 'distance 1.00' if not 1.0 m.\n"));

}

// ============================================================

void loop() {

handleSerial();

if (!collecting) return;

// ========== SEND POLL ==========

txBuffer[0] = MSG_POLL;

txBuffer[1] = 0x01; // initiator ID

DW1000.newTransmit();

DW1000.setData(txBuffer, 2);

DW1000.startTransmit();

if (!waitForTxDone(TX_TIMEOUT_MS)) {

clearStatusAll();

delay(RANGE_INTERVAL_MS);

return;

}

// T1 — poll TX timestamp

DW1000Time t1;

DW1000.getTransmitTimestamp(t1);

clearStatusAll();

// ========== WAIT FOR RESPONSE #1 (get T4) ==========

DW1000.newReceive();

DW1000.receivePermanently(false);

DW1000.startReceive();

if (!waitForRxGood(RX_TIMEOUT_MS)) {

clearStatusAll();

delay(RANGE_INTERVAL_MS);

return;

}

// T4 — response receive timestamp

DW1000Time t4;

DW1000.getReceiveTimestamp(t4);

// Signal diagnostics

float rxPower = DW1000.getReceivePower();

float fpPower = DW1000.getFirstPathPower();

float quality = DW1000.getReceiveQuality();

uint16_t len1 = DW1000.getDataLength();

if (len1 > sizeof(rxBuffer)) len1 = sizeof(rxBuffer);

DW1000.getData(rxBuffer, len1);

clearStatusAll();

// ========== WAIT FOR RESPONSE #2 (reply delay) ==========

DW1000.newReceive();

DW1000.receivePermanently(false);

DW1000.startReceive();

if (!waitForRxGood(RX_TIMEOUT_MS)) {

clearStatusAll();

delay(RANGE_INTERVAL_MS);

return;

}

uint16_t len2 = DW1000.getDataLength();

if (len2 > sizeof(rxBuffer)) len2 = sizeof(rxBuffer);

DW1000.getData(rxBuffer, len2);

clearStatusAll();

if (rxBuffer[0] != MSG_RESPONSE || len2 < 6) {

delay(RANGE_INTERVAL_MS);

return;

}

// Extract reply delay (T3 - T2) — 40-bit LE

int64_t replyDelay = 0;

replyDelay |= ((int64_t)rxBuffer[1] << 0);

replyDelay |= ((int64_t)rxBuffer[2] << 8);

replyDelay |= ((int64_t)rxBuffer[3] << 16);

replyDelay |= ((int64_t)rxBuffer[4] << 24);

replyDelay |= ((int64_t)rxBuffer[5] << 32);

// ========== COMPUTE ==========

int64_t roundTrip = t4.getTimestamp() - t1.getTimestamp();

if (roundTrip < 0) roundTrip += 0x10000000000LL; // 40-bit wrap

int64_t tofTicks = (roundTrip - replyDelay) / 2;

double tofSec = (double)tofTicks * DW_TIME_UNITS;

double distance = tofSec * SPEED_OF_LIGHT;

sampleCount++;

// Read environment every 25th sample (not every sample — I2C is slow)

if (sensorsAvail && (sampleCount % 25 == 0 || sampleCount == 1)) {

readEnvironment();

}

// ========== CSV OUTPUT ==========

// sample,millis,distance_m,round_trip_ticks,reply_delay_ticks,tof_ticks,

// rx_power_dBm,fp_power_dBm,quality,temp_C,pressure_hPa

Serial.print(sampleCount); Serial.print(',');

Serial.print(millis()); Serial.print(',');

Serial.print(distance, 4); Serial.print(',');

Serial.print((long)roundTrip); Serial.print(',');

Serial.print((long)replyDelay); Serial.print(',');

Serial.print((long)tofTicks); Serial.print(',');

Serial.print(rxPower, 2); Serial.print(',');

Serial.print(fpPower, 2); Serial.print(',');

Serial.print(quality, 2); Serial.print(',');

Serial.print(envTemp, 2); Serial.print(',');

Serial.println(envPressure, 1);

// ========== CHECK COMPLETION ==========

if (sampleCount >= targetSamples) {

collecting = false;

// Final environment reading

readEnvironment();

Serial.println(F("#"));

Serial.print(F("# Collection complete: ")); Serial.print(sampleCount); Serial.println(F(" samples"));

Serial.print(F("# End temp (C): ")); Serial.println(envTemp, 2);

Serial.print(F("# End pressure (hPa): ")); Serial.println(envPressure, 1);

Serial.println(F("#"));

Serial.println(F("# Paste CSV into cal_postprocess.py or spreadsheet."));

Serial.println(F("# To re-run: type 'start' or 'start N'"));

}

delay(RANGE_INTERVAL_MS);

}
