LukePepin/Marco-Polo/UWB/Collected Data/Antenna Delay of 16700 at 5.01 meters.png

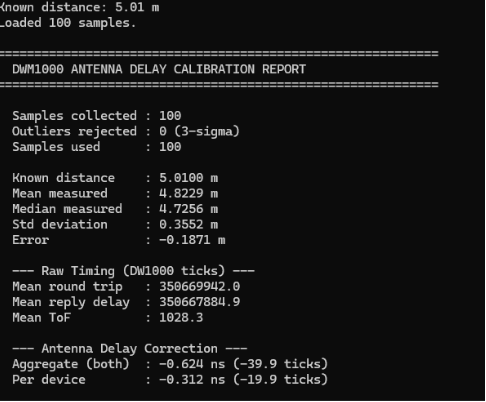
UWB/Collected Data/Antenna Delay of 16700 at 5.01 meters.png
