LukePepin/Marco-Polo/UWB_Telemetry_Engine/Assets/capstone-room-model/7_17_2026.obj

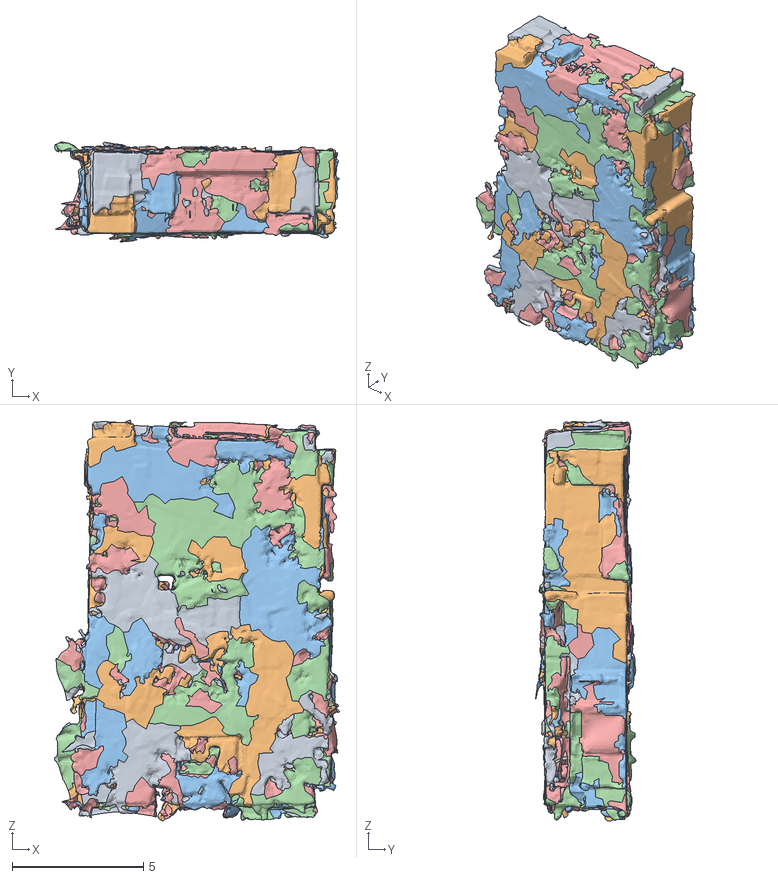
[picture p4: CAD file, 2026-07-18, last stored version]
UWB_Telemetry_Engine/Assets/capstone-room-model/7_17_2026.obj
10.9 x 3.83 x 15.3
