LukePepin/Marco-Polo/docs/lessons_learned.md

# Project Post-Mortem & Future Roadmap

As part of the project closure process, this document outlines the key lessons learned during the development of the Marco Polo tracking system, personal skill growth, and the strategic roadmap for future development.

---

## 🧠 Lessons Learned

### 1. 3D Environment Generation
During the development of the Unity Digital Twin, we experimented with using a phone camera for photogrammetry/scanning to rapidly generate 3D environments. 
* **Insight:** While phone camera scanning is not completely flawless and occasionally requires manual mesh cleanup, it is surprisingly effective and "pretty good" for establishing a base layer of reality for Digital Twins. It significantly accelerates the blocking-out phase of virtual environments.

### 2. Personal Skill Development
This project required a massive pivot from standard IoT backend development to front-end 3D visualization. 
* **Insight:** The transition into Unity required climbing a steep learning curve, but resulted in significant personal improvements in 3D modeling, C# scripting, and understanding game engine physics. The ability to bridge low-level microcontroller data (C++) with high-level 3D visualization (Unity/C#) is a highly valuable, full-stack engineering skill.

---

## 🚀 Future Roadmap (V5 and Beyond)

While the current Distributed UWB network successfully achieves high-precision indoor tracking, the system is designed to be scalable. The following objectives outline the next phase of development:

### 1. Hardware Scaling & Precision Metrics
* **Expanded Anchor Network:** Deploy additional Raspberry Pi base stations (Seekers) and UWB tags. Increasing the anchor count beyond 3 will allow us to transition from basic trilateration to a more robust **Multilateration** algorithm, resolving edge-case dead zones.
* **Empirical Testing:** Conduct rigorous physical testing to gather hard metrics on precision (e.g., standard deviation of error in millimeters) to quantify the exact accuracy of the UWB hardware.

### 2. Digital Twin Enhancements
* **Environment Polish:** Iterate on the Unity 3D model to create a more immersive, high-fidelity environment.
* **Model Optimization:** Improve the rendering pipeline and optimize the 3D meshes for smoother performance during live tracking.

### 3. Full-Stack Hybrid Tracking (The Ultimate Goal)
The ultimate vision for Marco Polo is a highly reliable, hybrid tracking system with multiple redundancies.
* **LoRa & GPS Integration:** Fully integrate the outdoor LoRa/GPS modules with the indoor UWB modules into a single, unified hardware stack. 
* **Seamless Handoff:** Ensure the system can dynamically switch between GPS (outdoor long-range) and UWB (indoor high-precision) without dropping the asset's location.

### 4. Machine Learning Integration
* **Smart Balancing:** Develop an ML model to intelligently balance and fuse the different communication and tracking methods. 
* **Use Case:** If the system is in a "fringe" environment (e.g., standing in a doorway where both GPS and UWB are weak), the ML model would dynamically weight the sensor data based on historical confidence metrics to accurately predict the target's location during search operations.

> **Conclusion:** The current architecture proves that the core concept works. The next phase transforms it from a working prototype into an enterprise-grade, ML-driven tracking network.
