LukePepin/Marco-Polo/v1/validate_gps.py

import serial
import time

ARDUINO_PORT = '/dev/ttyACM0'
ARDUINO_BAUD = 115200

def main():
    print("========================================")
    print("      GPS HARDWARE VALIDATION TOOL      ")
    print("========================================")
    
    try:
        arduino = serial.Serial(ARDUINO_PORT, ARDUINO_BAUD, timeout=1)
        print(f"✅ Connected to Arduino on {ARDUINO_PORT}")
    except serial.SerialException:
        print(f"❌ Could not connect to Arduino on {ARDUINO_PORT}. Ensure it is plugged in.")
        return
    
    print(">>> Listening for NMEA sentences from the Arduino...")
    print(">>> Take your setup outside if you want to get a satellite fix.")
    print(">>> Press Ctrl+C to exit.\n")
    
    try:
        while True:
            if arduino.in_waiting > 0:
                line = arduino.readline().decode('utf-8', errors='ignore').strip()
                if line:
                    print(line)
            time.sleep(0.01)

    except KeyboardInterrupt:
        print("\nExiting GPS Validator...")
    finally:
        arduino.close()

if __name__ == "__main__":
    main()
