LukePepin/Marco-Polo/(commit log)

2026-06-06 File Restructure
    [ble_cal_dataset.csv, cal_run1.csv, cal_run2.csv]
2026-06-10 Pin fix and file sort
    [hider_node.py, marco_hider.ino, polo_seeker.ino, seeker_node.py, system_verification.py, system_verification_win.py, validate_gps.py, validate_gps_win.py]
2026-07-16 Saved Jay-Sun TWR and Filter progess
2026-07-16 Fix DW1000 clock drift by scaling replyDelay using Carrier Integrator
    [polo_seeker.ino]
2026-07-16 Repository clean up: removed archive, old scripts, and v1-v3 firmware
    [ble_cal_dataset.csv, cal_run1.csv, cal_run2.csv]
2026-07-18 Unity Initialization
    [7_17_2026.obj]
2026-07-19 Optimize repo: ignore Unity heavy assets, keep scripts
    [7_17_2026.obj]
2026-07-20 Add --broker argument to seeker node
    [polo_seeker_node.py]
